YJQ486/course-project/Firmware/Core/Inc/main.h

#define MPU_INT_Pin GPIO_PIN_4
#define MPU_INT_GPIO_Port GPIOA
#define MPU_INT_EXTI_IRQn EXTI4_IRQn
#define OLED_SCL_Pin GPIO_PIN_10
#define OLED_SCL_GPIO_Port GPIOB
#define OLED_SDA_Pin GPIO_PIN_11
#define OLED_SDA_GPIO_Port GPIOB
#define ENC_KEY_Pin GPIO_PIN_12
#define ENC_KEY_GPIO_Port GPIOB
#define ENC_KEY_EXTI_IRQn EXTI15_10_IRQn
#define PWR_HOLD_Pin GPIO_PIN_8
#define PWR_HOLD_GPIO_Port GPIOA
