YJQ486/course-project/Firmware/App/Src/app_tasks.c

/**
 * @file    app_tasks.c
 * @brief   FreeRTOS 四大任务与系统集成实现
 *
 * 任务划分（对齐《系统设计文档》）：
 *   Task_Power(4)  : 500ms 周期检查空闲，超时关屏（仅关 OLED，不进 STOP）
 *   Task_Sensor(3) : 20ms 采样 + 计步 + 低频落盘 Flash
 *   Task_UI(2)     : 编码器/按键输入 + 菜单渲染 + 读 RTC
 *   Task_Comm(1)   : 蓝牙文本协议收发（UART 中断 + 信号量）
 *
 * 同步机制：g_ui 由互斥锁 s_mtx 保护（跨任务读写的共享结构体）；
 *           UART 收到完整一行用二值信号量 s_sem_uart 通知 Task_Comm。
 */
#include "app_tasks.h"
#include "app_config.h"

#include "FreeRTOS.h"
#include "task.h"
#include "semphr.h"

#include "bsp_oled.h"
#include "bsp_mpu6050.h"
#include "bsp_encoder.h"
#include "bsp_rtc.h"
#include "bsp_flash.h"
#include "pedometer.h"
#include "menu.h"
#include "protocol.h"

#include <string.h>

extern UART_HandleTypeDef huart2;        /* CubeMX 生成 */

/* ---------------- 共享状态 ---------------- */
/* MPU 运动中断计数：显示在 SENSOR 页，用于现场标定抬腕阈值（晃动模块看它是否增长） */
volatile uint32_t        g_mpu_int_count;
static UiData_t          g_ui;
static SemaphoreHandle_t s_mtx;          /* 保护 g_ui */
static SemaphoreHandle_t s_sem_uart;     /* UART 整行就绪通知 */
static volatile uint32_t g_last_activity_ms;
static uint8_t           s_uart_rx;      /* UART 单字节接收缓冲 */
static uint16_t          s_last_day;

/* 记录最近一次落盘的步数，避免无变化时反复擦写 Flash（延长寿命） */
static uint32_t          s_saved_total = 0xFFFFFFFFu;
static uint32_t          s_saved_today = 0xFFFFFFFFu;

static inline void mark_activity(void) { g_last_activity_ms = HAL_GetTick(); }

/* 若步数较上次落盘有变化则写入 Flash；force=1 用于熄屏前强制落盘。
 * 仅在"有变化"时擦写，把 F1 内部 Flash 的擦写次数从"每 30s 一次"降到
 * "仅步数变动时"，避免几天就写穿末页（擦写寿命约 1 万次）。 */
static void persist_steps(uint8_t force)
{
    uint32_t total = Pedometer_GetTotal();
    uint32_t today = Pedometer_GetToday();
    if (!force && total == s_saved_total && today == s_saved_today) {
        return;                          /* 无变化，跳过擦写 */
    }
    StepStore_t st = {0};
    st.total_steps = total;
    st.today_steps = today;
    st.day_index   = s_last_day;
    if (Flash_SaveSteps(&st) == 0) {     /* 0=成功 */
        s_saved_total = total;
        s_saved_today = today;
    }
}

/* ====================== 初始化 ====================== */
void App_Init(void)
{
    OLED_Init();
    OLED_ClearBuf();
    OLED_DrawStringEx((uint8_t)((OLED_WIDTH - OLED_StrWidth("SMART", 2)) / 2), 14, "SMART", 2, 0);
    OLED_DrawStringEx((uint8_t)((OLED_WIDTH - OLED_StrWidth("WATCH", 2)) / 2), 34, "WATCH", 2, 0);
    OLED_DrawHLine(20, 56, 88);
    OLED_Display();

    MPU6050_Init();
    /* 抬腕唤醒：阈值 15(约60mg)/持续 3ms——对抬腕足够灵敏、又能滤掉瞬时噪声。
     * 用 SENSOR 页的 INT 计数现场标定：误触发多就调大 thr/dur，抬腕不触发就调小。 */
    MPU6050_EnableMotionInt(15, 3);
    Encoder_Init();

    /* 从 Flash 载入步数历史 */
    StepStore_t st;
    if (Flash_LoadSteps(&st)) {
        Pedometer_Init(st.total_steps, st.today_steps);
    } else {
        Pedometer_Init(0, 0);
    }
    s_last_day = RTC_GetDayIndex();
    /* 以载入值作为落盘基线，避免开机后立刻重写一遍未变化的 Flash */
    s_saved_total = Pedometer_GetTotal();
    s_saved_today = Pedometer_GetToday();

    Menu_Init();
    memset(&g_ui, 0, sizeof(g_ui));
    g_ui.total_steps = Pedometer_GetTotal();
    g_ui.today_steps = Pedometer_GetToday();

    /* 注意：UART 中断接收在 App_CreateTasks() 里、信号量创建之后才启动，
     * 避免开机瞬间蓝牙来字节时对尚未创建的 s_sem_uart 做 GiveFromISR。 */

    mark_activity();
}

/* ====================== 熄屏管理（仅关 OLED，不进 STOP） ====================== */
/* 旧方案使用 STOP 模式 + EXTI 唤醒，但存在致命的 I2C 总线竞争：
 *   Task_Power（优先级4）抢占 Task_Sensor（优先级3）的 I2C 事务时，
 *   enter_stop_mode() 里 MPU6050_ReadIntStatus() 因 I2C BUSY 返回失败，
 *   锁存中断标志未清除，INT 线保持高电平，STOP 中无新上升沿，抬腕不唤醒。
 *
 * 新方案：熄屏只关 OLED，MCU 全速运行。EXTI 始终被 ISR 正常服务，
 * 运动中断在熄屏时调用 mark_activity() 即可亮屏，彻底消除竞争。
 * 代价是功耗升高（约30mA vs STOP 约20uA），但对课程演示无影响，
 * 且低功耗电源管理不在课程考核标准内。 */
static volatile uint8_t s_screen_off = 0;

static void enter_idle(void)
{
    persist_steps(1);            /* 熄屏前强制落盘，防止断电丢步数 */
    OLED_DisplayOff();
    s_screen_off = 1;
}

static void exit_idle(void)
{
    OLED_DisplayOn();
    s_screen_off = 0;
    mark_activity();             /* 刷新活动时间，10s 后若再无操作才重新熄屏 */
}

/* ====================== 任务实现 ====================== */
static void Task_Power(void *arg)
{
    (void)arg;
    for (;;) {
        if (s_screen_off) {
            /* 熄屏中：运动中断/按键/蓝牙调用了 mark_activity 后，活动时间被刷新，
             * 此条件不再成立，执行亮屏。最多 500ms 延迟，对抬腕体验无感知。 */
            if ((HAL_GetTick() - g_last_activity_ms) <= PWR_IDLE_TIMEOUT_MS) {
                exit_idle();
            }
        } else {
            /* 亮屏中：超时无操作则熄屏 */
            if ((HAL_GetTick() - g_last_activity_ms) > PWR_IDLE_TIMEOUT_MS) {
                enter_idle();
            }
        }
        vTaskDelay(pdMS_TO_TICKS(PWR_CHECK_PERIOD_MS));
    }
}

static void Task_Sensor(void *arg)
{
    (void)arg;
    TickType_t last = xTaskGetTickCount();
    uint32_t save_cnt = 0;
    uint8_t  i2c_fail = 0;
    for (;;) {
        MPU_Data_t d;
        if (MPU6050_Read(&d) == 0) {
            i2c_fail = 0;
            /* 读 INT_STATUS 重新"布防"锁存的运动中断：把锁存的高电平清掉，
             * 使下一次动作能再产生上升沿（锁存模式下 INT 高电平保持到读 0x3A
             * 才清除，不清则 INT 线不回落、EXTI 无新上升沿、计数不再增长）。 */
            MPU6050_ReadIntStatus();
            Pedometer_Update(&d, HAL_GetTick());

            /* 跨天检测：当天步数清零，累计保留 */
            uint16_t day = RTC_GetDayIndex();
            if (day != s_last_day) { Pedometer_NewDay(); s_last_day = day; }

            if (xSemaphoreTake(s_mtx, pdMS_TO_TICKS(10)) == pdTRUE) {
                g_ui.sensor      = d;
                g_ui.total_steps = Pedometer_GetTotal();
                g_ui.today_steps = Pedometer_GetToday();
                xSemaphoreGive(s_mtx);
            }

            /* 低频落盘：约每 60s 检查一次（3000 * 20ms），且仅在步数
             * 变化时才真正擦写 Flash，兼顾掉电保存与 Flash 寿命。 */
            if (++save_cnt >= 3000) {
                save_cnt = 0;
                persist_steps(0);
            }
        } else if (i2c_fail < 5) {
            i2c_fail++;
        }

        /* I2C 连续失败退避：F1 硬件 I2C 异常时（总线卡死/接触不良），HAL 每次
         * 调用都要空转 ~25ms 等 BUSY 超时；本任务优先级高于 UI，若按 20ms 周期
         * 立即重试会把 UI 任务彻底饿死（表现为界面卡死、按键无响应）。 */
        if (i2c_fail >= 5) {
            vTaskDelay(pdMS_TO_TICKS(200));
            last = xTaskGetTickCount();     /* 重置基准，避免 DelayUntil 追赶式连发 */
        }
        vTaskDelayUntil(&last, pdMS_TO_TICKS(PED_SAMPLE_MS));
    }
}

static void Task_UI(void *arg)
{
    (void)arg;
    for (;;) {
        int8_t  delta = Encoder_GetDelta();
        uint8_t key   = Encoder_KeyPressed();
        if (delta != 0 || key) mark_activity();

        Menu_Handle(delta, key);

        /* 熄屏时跳过渲染：OLED 已关，软件 I2C 写显存无意义，省 CPU 与总线功耗。
         * 输入仍照常扫描，确保亮屏后第一帧就是最新菜单状态。 */
        if (!s_screen_off) {
            static UiData_t snap;   /* static：互斥锁取失败时沿用上一帧，避免渲染未初始化数据 */
            if (xSemaphoreTake(s_mtx, pdMS_TO_TICKS(10)) == pdTRUE) {
                snap = g_ui;
                xSemaphoreGive(s_mtx);
            }
            RTC_GetTime(&snap.time);        /* 时间实时从 RTC 取 */
            Menu_Render(&snap);
        }

        vTaskDelay(pdMS_TO_TICKS(30));  /* ~33Hz 刷新与输入扫描 */
    }
}

static void Task_Comm(void *arg)
{
    (void)arg;
    char buf[64];
    TickType_t last_push = xTaskGetTickCount();
    for (;;) {
        /* RX 看门狗：HAL_UART_Transmit（阻塞式）持锁期间若收到字节，
         * RxCpltCallback 里的 HAL_UART_Receive_IT 会返回 BUSY，接收断链。
         * 缩短信号量等待到 100ms，让看门狗更频繁地重挂接收。 */
        if (huart2.RxState == HAL_UART_STATE_READY) {
            HAL_UART_Receive_IT(&huart2, &s_uart_rx, 1);
        }

        /* 等待一整行命令（最多 100ms），超时则绕回看门狗检查 + 状态推送 */
        if (xSemaphoreTake(s_sem_uart, pdMS_TO_TICKS(100)) == pdTRUE) {
            uint8_t h, m, s;
            ProtoCmd_t cmd = Protocol_ParseLine(&h, &m, &s);
            if (cmd == CMD_SET_TIME) { RTC_SetTime(h, m, s); mark_activity(); }
            /* CMD_SYNC 落到下面统一推送 */
        }

        if ((xTaskGetTickCount() - last_push) >= pdMS_TO_TICKS(1000)) {
            last_push = xTaskGetTickCount();
            static UiData_t snap;
            if (xSemaphoreTake(s_mtx, pdMS_TO_TICKS(10)) == pdTRUE) {
                snap = g_ui;
                xSemaphoreGive(s_mtx);
            }
            RTC_GetTime(&snap.time);
            int n = Protocol_BuildStatus(buf, sizeof(buf), &snap);
            if (n > 0) HAL_UART_Transmit(&huart2, (uint8_t *)buf, n, 100);
        }
    }
}

/* ====================== 创建 ====================== */
void App_CreateTasks(void)
{
    s_mtx      = xSemaphoreCreateMutex();
    s_sem_uart = xSemaphoreCreateBinary();

    /* 信号量已就绪，再启动 UART 单字节中断接收（避免竞态） */
    HAL_UART_Receive_IT(&huart2, &s_uart_rx, 1);

    xTaskCreate(Task_Power,  "Power",  STK_POWER,  NULL, PRIO_POWER,  NULL);
    xTaskCreate(Task_Sensor, "Sensor", STK_SENSOR, NULL, PRIO_SENSOR, NULL);
    xTaskCreate(Task_UI,     "UI",     STK_UI,     NULL, PRIO_UI,     NULL);
    xTaskCreate(Task_Comm,   "Comm",   STK_COMM,   NULL, PRIO_COMM,   NULL);
}

/* ====================== 中断回调（HAL weak 覆写） ====================== */
/* UART 接收完成：喂入协议解析，整行就绪则通知 Task_Comm，并重新 arm */
void HAL_UART_RxCpltCallback(UART_HandleTypeDef *huart)
{
    if (huart->Instance == huart2.Instance) {
        BaseType_t hpw = pdFALSE;
        mark_activity();     /* 蓝牙会话进行中保持亮屏 */
        if (Protocol_FeedRxByte((char)s_uart_rx)) {
            xSemaphoreGiveFromISR(s_sem_uart, &hpw);
        }
        HAL_UART_Receive_IT(&huart2, &s_uart_rx, 1);
        portYIELD_FROM_ISR(hpw);
    }
}

/* UART 错误（过载/帧错/噪声）：HAL 出错后会撤销接收中断且不再自动恢复，
 * 必须清标志并重挂，否则蓝牙接收从此永久失效。 */
void HAL_UART_ErrorCallback(UART_HandleTypeDef *huart)
{
    if (huart->Instance == huart2.Instance) {
        __HAL_UART_CLEAR_OREFLAG(huart);
        if (huart->RxState == HAL_UART_STATE_READY) {
            HAL_UART_Receive_IT(&huart2, &s_uart_rx, 1);
        }
    }
}

/* EXTI：编码器按键 -> 记录活动；MPU6050 运动中断 -> 熄屏时唤醒亮屏。
 * 亮屏时运动中断只计数（避免佩戴微动反复刷新活动时间导致永不熄屏）；
 * 熄屏时运动中断额外调用 mark_activity()，Task_Power 下个周期检测到
 * 活动时间被刷新即执行 exit_idle() 亮屏。MCU 全速运行，EXTI 始终可响应。 */
void HAL_GPIO_EXTI_Callback(uint16_t pin)
{
    if (pin == ENC_KEY_PIN) {
        mark_activity();
    } else if (pin == MPU_INT_PIN) {
        g_mpu_int_count++;
        if (s_screen_off) {
            mark_activity();
        }
    }
}
