YJQ486/course-project/Firmware/App/Inc/oled_font.h

/**
 * @file    oled_font.h
 * @brief   6x8 ASCII 点阵字库（可打印字符 0x20~0x7E，每字符 6 字节，列向取模）
 *
 * 说明：本表为各开源 OLED 教程中广泛使用的标准 6x8 ASCII 字库，用于点亮
 * 验证与英文/数字界面显示。若需中文或大号时间字体，请用 PCtoLCD2002 等
 * 取模软件按“列行式、逆向”重新生成后追加替换，无需改动驱动逻辑。
 *
 * 取模方式：每个字符 6 列，每列 1 字节 = 8 行（bit0 在顶部，bit7 在底部）。
 */
#ifndef OLED_FONT_H
#define OLED_FONT_H

#include <stdint.h>

static const uint8_t F6x8[][6] = {
    {0x00,0x00,0x00,0x00,0x00,0x00}, // sp  0x20
    {0x00,0x00,0x2f,0x00,0x00,0x00}, // !
    {0x00,0x07,0x00,0x07,0x00,0x00}, // "
    {0x14,0x7f,0x14,0x7f,0x14,0x00}, // #
    {0x24,0x2a,0x7f,0x2a,0x12,0x00}, // $
    {0x23,0x13,0x08,0x64,0x62,0x00}, // %
    {0x36,0x49,0x55,0x22,0x50,0x00}, // &
    {0x00,0x05,0x03,0x00,0x00,0x00}, // '
    {0x00,0x1c,0x22,0x41,0x00,0x00}, // (
    {0x00,0x41,0x22,0x1c,0x00,0x00}, // )
    {0x14,0x08,0x3e,0x08,0x14,0x00}, // *
    {0x08,0x08,0x3e,0x08,0x08,0x00}, // +
    {0x00,0x50,0x30,0x00,0x00,0x00}, // ,
    {0x08,0x08,0x08,0x08,0x08,0x00}, // -
    {0x00,0x60,0x60,0x00,0x00,0x00}, // .
    {0x20,0x10,0x08,0x04,0x02,0x00}, // /
    {0x3e,0x51,0x49,0x45,0x3e,0x00}, // 0  0x30
    {0x00,0x42,0x7f,0x40,0x00,0x00}, // 1
    {0x42,0x61,0x51,0x49,0x46,0x00}, // 2
    {0x21,0x41,0x45,0x4b,0x31,0x00}, // 3
    {0x18,0x14,0x12,0x7f,0x10,0x00}, // 4
    {0x27,0x45,0x45,0x45,0x39,0x00}, // 5
    {0x3c,0x4a,0x49,0x49,0x30,0x00}, // 6
    {0x01,0x71,0x09,0x05,0x03,0x00}, // 7
    {0x36,0x49,0x49,0x49,0x36,0x00}, // 8
    {0x06,0x49,0x49,0x29,0x1e,0x00}, // 9
    {0x00,0x36,0x36,0x00,0x00,0x00}, // :
    {0x00,0x56,0x36,0x00,0x00,0x00}, // ;
    {0x08,0x14,0x22,0x41,0x00,0x00}, // <
    {0x14,0x14,0x14,0x14,0x14,0x00}, // =
    {0x00,0x41,0x22,0x14,0x08,0x00}, // >
    {0x02,0x01,0x51,0x09,0x06,0x00}, // ?
    {0x32,0x49,0x79,0x41,0x3e,0x00}, // @  0x40
    {0x7e,0x11,0x11,0x11,0x7e,0x00}, // A
    {0x7f,0x49,0x49,0x49,0x36,0x00}, // B
    {0x3e,0x41,0x41,0x41,0x22,0x00}, // C
    {0x7f,0x41,0x41,0x22,0x1c,0x00}, // D
    {0x7f,0x49,0x49,0x49,0x41,0x00}, // E
    {0x7f,0x09,0x09,0x09,0x01,0x00}, // F
    {0x3e,0x41,0x49,0x49,0x7a,0x00}, // G
    {0x7f,0x08,0x08,0x08,0x7f,0x00}, // H
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
    {0x02,0x04,0x08,0x10,0x20,0x00}, // backslash
    {0x00,0x41,0x41,0x7f,0x00,0x00}, // ]
    {0x04,0x02,0x01,0x02,0x04,0x00}, // ^
    {0x40,0x40,0x40,0x40,0x40,0x00}, // _
    {0x00,0x01,0x02,0x04,0x00,0x00}, // `  0x60
    {0x20,0x54,0x54,0x54,0x78,0x00}, // a
    {0x7f,0x48,0x44,0x44,0x38,0x00}, // b
    {0x38,0x44,0x44,0x44,0x20,0x00}, // c
    {0x38,0x44,0x44,0x48,0x7f,0x00}, // d
    {0x38,0x54,0x54,0x54,0x18,0x00}, // e
    {0x08,0x7e,0x09,0x01,0x02,0x00}, // f
    {0x0c,0x52,0x52,0x52,0x3e,0x00}, // g
    {0x7f,0x08,0x04,0x04,0x78,0x00}, // h
    {0x00,0x44,0x7d,0x40,0x00,0x00}, // i
    {0x20,0x40,0x44,0x3d,0x00,0x00}, // j
    {0x7f,0x10,0x28,0x44,0x00,0x00}, // k
    {0x00,0x41,0x7f,0x40,0x00,0x00}, // l
    {0x7c,0x04,0x18,0x04,0x78,0x00}, // m
    {0x7c,0x08,0x04,0x04,0x78,0x00}, // n
    {0x38,0x44,0x44,0x44,0x38,0x00}, // o
    {0x7c,0x14,0x14,0x14,0x08,0x00}, // p  0x70
    {0x08,0x14,0x14,0x18,0x7c,0x00}, // q
    {0x7c,0x08,0x04,0x04,0x08,0x00}, // r
    {0x48,0x54,0x54,0x54,0x20,0x00}, // s
    {0x04,0x3f,0x44,0x40,0x20,0x00}, // t
    {0x3c,0x40,0x40,0x20,0x7c,0x00}, // u
    {0x1c,0x20,0x40,0x20,0x1c,0x00}, // v
    {0x3c,0x40,0x30,0x40,0x3c,0x00}, // w
    {0x44,0x28,0x10,0x28,0x44,0x00}, // x
    {0x0c,0x50,0x50,0x50,0x3c,0x00}, // y
    {0x44,0x64,0x54,0x4c,0x44,0x00}, // z
    {0x00,0x08,0x36,0x41,0x00,0x00}, // {
    {0x00,0x00,0x7f,0x00,0x00,0x00}, // |
    {0x00,0x41,0x36,0x08,0x00,0x00}, // }
    {0x10,0x08,0x08,0x10,0x08,0x00}, // ~  0x7E
};

#endif /* OLED_FONT_H */
