YJQ486/course-project/(commit log)

2026-06-29 Update README with project details and features
    This README provides an overview of the smart watch project based on STM32F103C8T6, detailing features, hardware components, software architecture, and development progress.
2026-06-30 Create 项目计划书
2026-06-30 Add system design document for STM32 smart watch
    This document outlines the design of a smart watch based on STM32, detailing material procurement, system architecture, hardware and software design, and project progress.
2026-06-30 docs: 优化设计文档与计划书的关键技术方案
    - 走时方案由 SysTick 软件计时改为片内 RTC + 板载 32.768kHz 晶振(LSE)，
    解决进入 STOP 低功耗后 SysTick 停摆、时间丢失的矛盾(休眠持续走时)
    - OLED 改软件模拟 I2C、MPU6050 用硬件 I2C1，两路总线物理隔离；
    修正"互斥锁解决 I2C 冲突"的口径(无共享总线则无需 I2C 互斥锁)
    - Task_Power 由最高优先级忙等轮询改为 500ms 周期+事件标志，避免饿死任务
    - 明确 STOP 唤醒源为 EXTI(按键/MPU 抬腕中断)，编码器旋转不可唤醒；
    补全 MPU6050 运动中断 INT->EXTI 抬腕亮屏方案
    - 新增步数历史内部 Flash 掉电持久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
2026-06-30 feat: 新增固件应用层骨架、蓝牙上位机与集成文档
    固件 App 层(与 CubeMX 解耦，可直接接入 CubeIDE 工程):
    - BSP 驱动: 软件 I2C/OLED(SH1106 兼容)、MPU6050(硬件 I2C1+抬腕中断)、
    EC11 编码器(TIM2 正交解码)、RTC 走时(LSE)、内部 Flash 持久化
    - 计步算法 pedometer: 合加速度+滑动平均+动态阈值波峰检测(纯整数)
    - 多级菜单状态机 menu: 时间/计步/传感器/校时四页
    - 蓝牙文本行协议 protocol
    - FreeRTOS 四大任务 app_tasks: Power/Sensor/UI/Comm + 互斥锁/信号量
    + STOP 低功耗进入与唤醒重配时钟 + UART 中断接收
    - app_config.h 集中引脚与参数配置
    上位机 Host: PyQt5+pyse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
2026-06-30 feat: 新增 CubeMX 预配置工程(.ioc)与 7/6 中期检查报告
    - Firmware/SmartWatch.ioc: STM32F103C8T6 预配置工程，含 HSE/LSE 72MHz 时钟、
    RTC(LSE)、I2C1、USART2(9600)、TIM2 编码器模式、GPIO/EXTI(PA4抬腕/PB12按键)、
    FreeRTOS、HAL Timebase=TIM4。打开后按校验清单确认即可 Generate Code
    - CubeMX配置清单.md: 新增"快速开始(.ioc)+打开后 9 项必查清单"，手动清单保留为兜底
    - Docs/中期检查报告.md: 7/6 中期检查报告模板，预填已确定内容与技术障碍解决方案，
    标注待联调补充项
2026-07-01 chore: 适配 VSCode+CMake 工具链
    - SmartWatch.ioc: TargetToolchain 由 STM32CubeIDE 改为 CMake
    - 集成说明.md: 新增第七节"VSCode+CMake 集成"(把 App 加进 CMakeLists、
    cmake/ninja 编译命令、OpenOCD 烧录命令)
    - CubeMX配置清单.md: 生成代码一节改为 CMake 工具链与就地生成说明
    - .gitignore: 忽略 build/ 等 CMake 产物
2026-07-01 feat: 集成 CubeMX 生成工程，编译通过并修复问题
    - 导入 CubeMX(6.17)生成的完整工程：Core/Drivers/Middlewares，
    SWD=Serial Wire、72MHz(HSE×9)、RTC(LSE)、I2C1/USART2/TIM2编码器/EXTI
    - 集成 App 到 CMake(顶层 CMakeLists 挂 App/Src+App/Inc)与 main.c
    (App_Init/App_CreateTasks/#include app_tasks.h，均在 USER CODE 区)
    - 修复 bsp_oled.c 缺少 HAL 头导致 HAL_Delay 隐式声明
    - 修复 RTC 每次复位清零：MX_RTC_Init 加备份寄存器(BKP_DR1)魔数判断，
    已初始化则跳过设时，复位不再丢时间(断电无 VBAT 仍会丢)
    - 已用 arm-none-eabi-gcc 实测编译通过：RAM 74.65%、FLASH 70.59%，
    产出 SmartWatch.elf
    Co-Aut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
    [SmartWatch.ioc, bsp_oled.c, main.c, main.h]
2026-07-01 fix: 修补固件隐患并新增接线图
    - app_tasks: UART 接收改到信号量创建后启动，消除开机竞态
    - app_tasks: Flash 落盘改脏检查(仅步数变化才擦写)+进STOP前落盘，省擦写寿命
    - menu: 传感器页加陀螺仪双列显示，补齐基本要求"陀螺仪"
    - README: 修工具链(CMake/Ninja)与上位机路径不一致
    - Hardware: 新增接线图.md(Mermaid+ASCII+引脚表)
    已本地 arm-gcc 编译链接通过(RAM 74.69%/FLASH 70.96%)
    [app_tasks.c, menu.c]
2026-07-01 fix: 修复 STOP 抬腕唤醒失效(MPU 中断锁存)并补中期报告
    现象：进 STOP 后抬腕无法唤醒，仅编码器按键可唤醒。
    根因：MPU6050 INT 配为锁存模式(0x20)，中断置位后不读 INT_STATUS
    便一直保持高电平，进 STOP 时 PA4 已锁存为高，上升沿 EXTI 无新边沿。
    修复：
    - bsp_mpu6050: INT_PIN_CFG 改非锁存脉冲(0x00)，新增 MPU6050_ReadIntStatus()
    - app_tasks: 进 STOP 前读 INT_STATUS + 清 EXTI/NVIC 挂起，保证干净低电平进休眠
    - 中期报告：补第三节联调问题#5(抬腕唤醒)与#6(熄屏不计步为设计取舍)
    本地 arm-gcc 编译链接通过(RAM 74.69%/FLASH 71.15%)；真机待复测。
    Co-Auth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
    [app_tasks.c, bsp_mpu6050.c, bsp_mpu6050.h]
2026-07-02 fix: 修复蓝牙断链、卡死不熄屏与抬腕唤醒失效三问题
    问题1 蓝牙只能收不能发:
    - UART 收到字节即 mark_activity, 蓝牙会话期间不休眠(STOP 下 USART2 无时钟)
    - 新增 HAL_UART_ErrorCallback: ORE/FE 后清标志重挂, 接收不再永久失效
    - Task_Comm 加 RX 看门狗, 兜底 HAL 收发锁冲突导致的接收断链
    - STOP 唤醒后 AbortReceive+重挂, 清休眠期间残留错误状态
    问题2 开机偶发卡 TIME 页且不熄屏:
    - MPU 运动中断不再刷新活动时间(手持微动导致永不熄屏), 改为仅计数
    - PA4 由浮空改内部下拉(main.c+.ioc), 杜绝松线时 EXTI 中断风暴饿死任务
    - Task_Sensor I2C 连续失败退避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
    [SmartWatch.ioc, app_tasks.c, app_tasks.h, bsp_mpu6050.c, main.c, menu.c]
2026-07-05 fix: 补齐 MPU6050 wake-on-motion 标准时序, 修复抬腕唤不醒
    第一轮修复(改脉冲模式+放宽DLPF)真机复测仍唤不醒。第二轮查数据手册与
    多方验证实现后定位两个真正根因(EXTI/STOP 链路完好, 按键能醒即证明,
    坏在 MPU 根本不产生 INT):
    - 缺信号通路复位: 未写 SIGNAL_PATH_RESET(0x68)=0x07, 运动检测高通滤波器
    残留旧状态, 阈值比较器永不翻转 → INT 从不产生。此为必备首步, 此前遗漏。
    - 脉冲模式反而不可靠: ~50us 脉冲经杜邦线+输入电容后 EXTI 常抓不到边沿。
    改回锁存模式 INT_PIN_CFG=0x20, INT 保持高电平直到读 0x3A 清除。
    修复:
    - EnableMotionInt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
    [app_tasks.c, bsp_mpu6050.c]
2026-07-06 fix: 移除STOP模式改为仅关屏，修复抬腕唤醒失败
    根因：Task_Power(优先级4)抢占Task_Sensor(优先级3)的I2C事务时，
    MPU6050_ReadIntStatus()因I2C BUSY失败，锁存INT线保持高电平，
    STOP中无新上升沿导致抬腕无法唤醒。
    改动：
    - app_tasks.c: enter_stop_mode→enter_idle/exit_idle（仅关OLED），
    运动中断在熄屏时才mark_activity()，Task_UI熄屏时跳过渲染，
    Task_Comm信号量等待从1s缩短到100ms加快RX看门狗
    - bsp_mpu6050.c: DHPF从5Hz改为1.25Hz（保留更多走路/抬腕信号），
    MOT_THR注释更正为4mg/LSB
    - 文档同步更新：故障排查记录、系统设计文档、CubeMX配置清单
    [app_tasks.c, bsp_mpu6050.c]
2026-07-08 feat: OLED界面可视化重构 + Flash并发与OLED总线加固
    UI/UX 重构：
    - 新增 OLED 绘图原语（画点/矩形/线/进度条、可缩放大字号、反白绘制）
    - 四页重绘：反白标题栏+页码、大号时钟+秒进度条、步数目标进度条、
    传感器ACC/GYRO分栏、校时字段反白高亮、SMART/WATCH 开机页
    并发加固：
    - persist_steps() 增加 s_flash_mtx 互斥锁，消除 Task_Sensor 与
    Task_Power 并发擦写内部 Flash 的潜在 HardFault
    - OLED 亮灭改由 Task_UI 统一执行，OLED 软件 I2C 总线严格单任务访问
    文档一致性：
    - README 低功耗描述、目录树、路径与最终"仅关屏"实现对齐
    - 故障排查记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
2026-07-08 revert: 回退 Flash 互斥锁与 OLED 亮灭任务迁移，仅保留 UI 重构
    真机复测发现上一提交的两处并发加固会影响抬腕唤醒稳定性，故回退：
    - app_tasks.c 运行时逻辑（enter_idle/exit_idle/Task_UI/persist_steps/
    任务创建）恢复到已验证可用的 f13d444，唯一保留的改动是开机 SMART/WATCH
    启动画面（仅渲染，不触及唤醒链路）
    - 故障排查记录相应改为仅记录界面重构，并注明并发加固已回退
    menu.c / bsp_oled 绘图原语 / 大字号界面等 UI 重构全部保留。
    编译通过(arm-none-eabi-gcc)，RAM 74.96% / FLASH 74.01%，与工作版本一致。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
    [app_tasks.c]
2026-07-11 docs: README 重写为课程设计验收报告，如实标注计步精度不足
