YJQ486/course-project/(notices)

Notices in the files:
Firmware/Core/Inc/main.h:
Copyright (c) 2026 STMicroelectronics.
All rights reserved.
This software is licensed under terms that can be found in the LICENSE file
